RogerDeng/sdlocker-tiny/hardware_smol/sd_slot.STEP

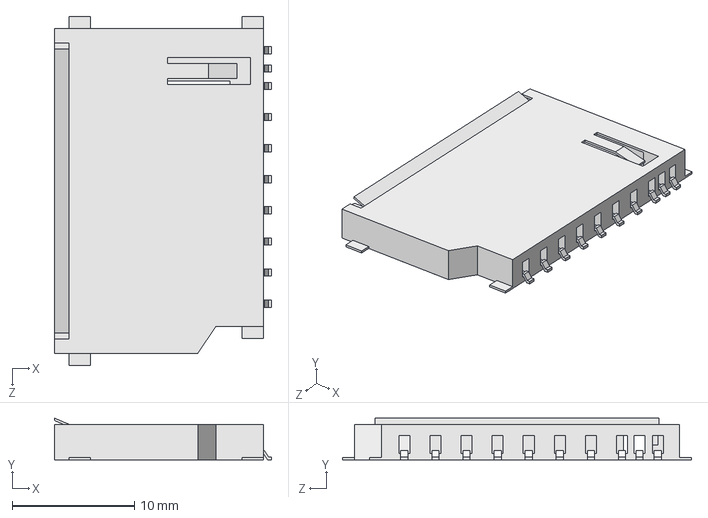
[picture p1: CAD file, 2022-03-17]
hardware_smol/sd_slot.STEP
17.8 x 3.40 x 28.5 mm
