RogerDeng/sdlocker-tiny/hardware_smol/sd_locker.kicad_pcb

## KiCad design hardware_smol/sd_locker.kicad_pcb (2022-03-17)

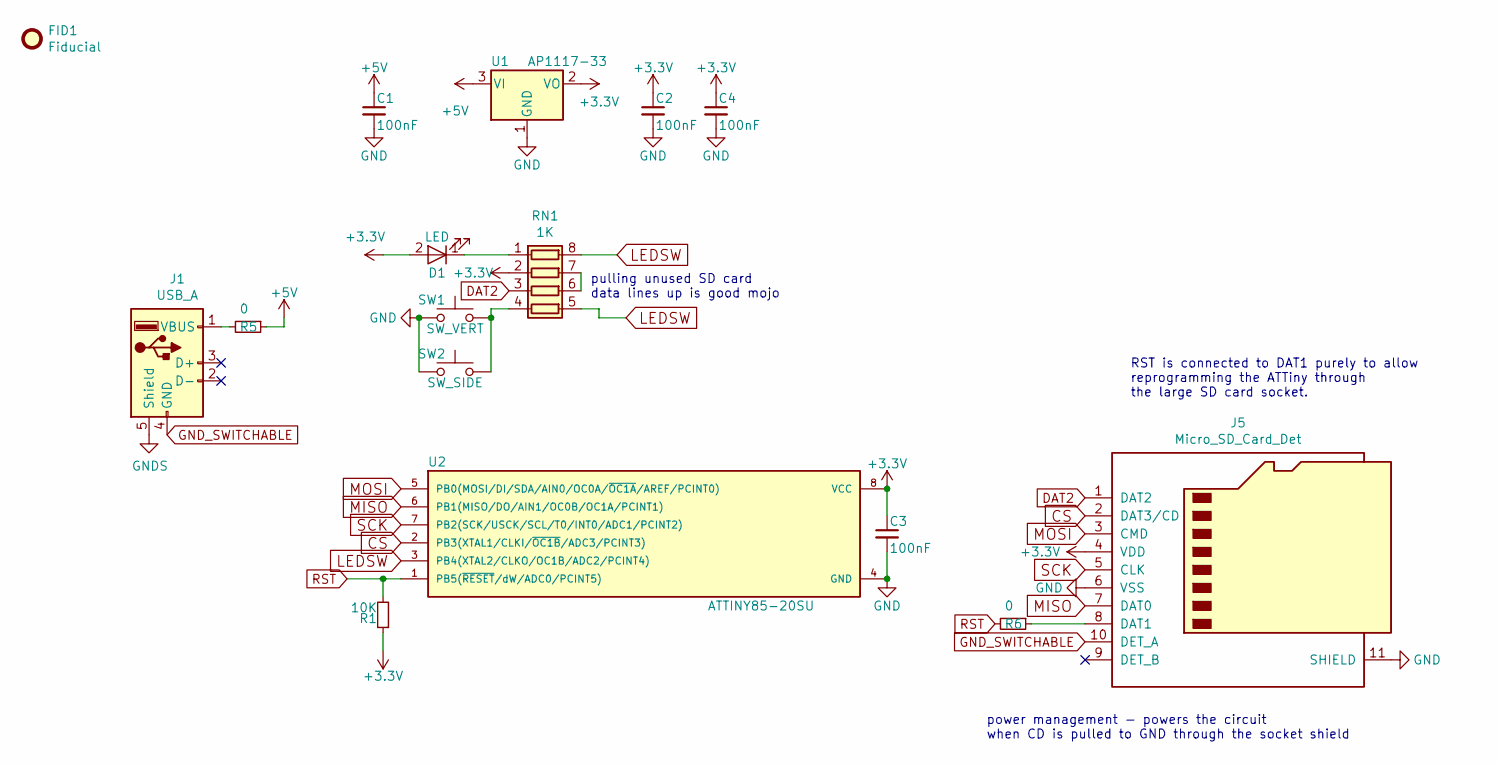
[picture p2: schematic sd_locker.sch]

Parts:
C1, C2, C3, C4: 100nF; C_0805_100nF_HandSoldering
D1: LED; LED_0805_HandSoldering
FID1: Fiducial; Fiducial_1.5mm_Mask3mm
J1: USB_A; USB_A_CNCTech_1001-011-01101_Horizontal
J5: Micro_SD_Card_Det; microSD-Receptacle-SelfEject
R1: 10K; R_0805_10K_HandSoldering
R5, R6: 0; R_0603_1608Metric_Pad1.05x0.95mm_HandSolder
RN1: 1K; R_Array_Concave_4x0402
SW1: SW_VERT; SW_SPST_EVQPE1
SW2: SW_SIDE; Panasonic_EVQPUL_EVQPUC
U1: AP1117-33; SOT-223-3_TabPin2
U2: ATTINY85-20SU; SOIJ-8_5.3x5.3mm_Pitch1.27mm

Connections:
+3V3: C2.1, C3.1, C4.1, D1.2 (A), J5.4 (VDD), R1.1, RN1.2 (R2.1), U1.2 (VO), U2.8 (VCC)
+5V: C1.1, R5.1, U1.3 (VI)
CS: J5.2 (DAT3/CD), U2.2 (PB3(XTAL1/CLKI/~OC1B~/ADC3/PCINT3))
DAT2: J5.1 (DAT2), RN1.3 (R3.1)
GND: C1.2, C2.2, C3.2, C4.2, J5.6 (VSS), J5.11 (SHIELD), SW1.2, SW2.2, U1.1 (GND), U2.4 (GND)
GNDS: J1.5 (Shield)
GND_SWITCHABLE: J1.4 (GND), J5.10 (DET_A)
LEDSW: RN1.5 (R4.2), RN1.8 (R1.2), U2.3 (PB4(XTAL2/CLKO/OC1B/ADC2/PCINT4))
MISO: J5.7 (DAT0), U2.6 (PB1(MISO/DO/AIN1/OC0B/OC1A/PCINT1))
MOSI: J5.3 (CMD), U2.5 (PB0(MOSI/DI/SDA/AIN0/OC0A/~OC1A~/AREF/P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)
unnamed: D1.1 (K), RN1.1 (R1.1)
unnamed: J1.1 (VBUS), R5.2
unnamed: J5.8 (DAT1), R6.1
unnamed: RN1.4 (R4.1), SW1.1, SW2.1
unnamed: RN1.6 (R3.2), RN1.7 (R2.2)
RST: R1.2, R6.2, U2.1 (PB5(~RESET~/dW/ADC0/PCINT5))
SCK: J5.5 (CLK), U2.7 (PB2(SCK/USCK/SCL/T0/INT0/ADC1/PCINT2))

Notes on the sheet:
RST is connected to DAT1 purely to allow reprogramming the ATTiny through the large SD card socket.
power management - powers the circuit when CD is pulled to GND through the socket shield
pulling unused SD card data lines up is good mojo

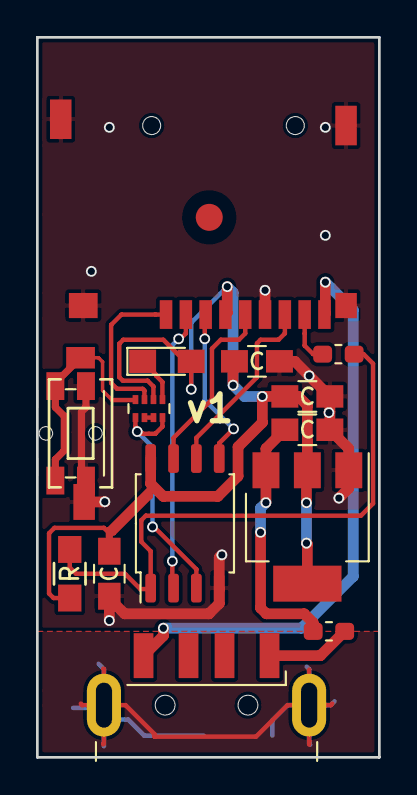
[picture p3: board sd_locker.kicad_pcb from above]

Board: 2 copper layers, 19.0 x 40.0 mm, 16 parts (0 on the bottom side), 16 nets.
