RogerDeng/sdlocker-tiny/hardware_smol/programming_adapter/usd-adapter.kicad_pcb

## KiCad design hardware_smol/programming_adapter/usd-adapter.kicad_pcb (2022-03-17)

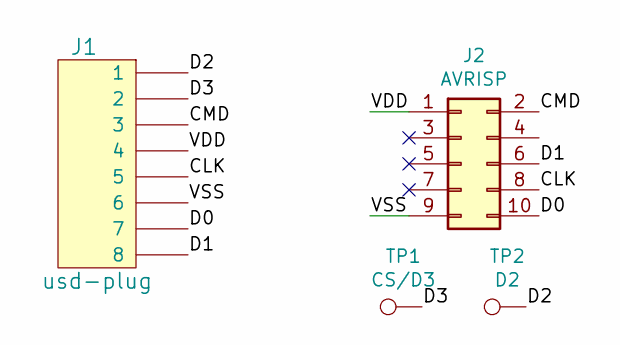
[picture p4: schematic usd-adapter.sch, Micro SD card adapter]

Parts:
J1: usd-plug; usd
J2: AVRISP; Side_2x5_Connector_SMD
TP1: CS/D3; TestPoint_Pad_1.0x1.0mm
TP2: D2; TestPoint_Pad_1.0x1.0mm

Connections:
/CLK: J1.5, J2.8
/CMD: J1.3, J2.2
/D0: J1.7, J2.10
/D1: J1.8, J2.6
/D2: J1.1, TP2.1
/D3: J1.2, TP1.1
/VDD: J1.4, J2.1
/VSS: J1.6, J2.9

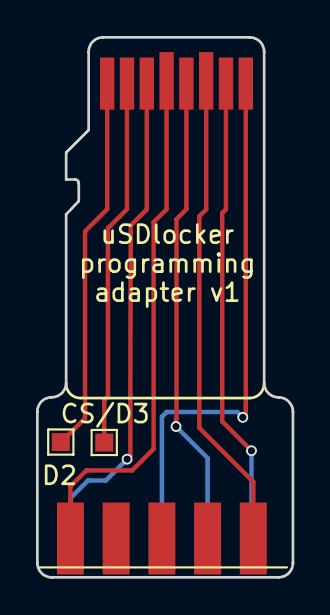
[picture p5: board usd-adapter.kicad_pcb from above]

Board: 2 copper layers, 14.2 x 30.0 mm, 4 parts (0 on the bottom side), 8 nets.
