RogerDeng/sdlocker-tiny/(commit log)

2018-12-15 I have broken pinout on rev1 of my PCBs, working around some of it in software
    [sdlocker-tiny.cpp]
2018-12-15 Added PERM bit support and dynamic TMP-to-PERM switching when the button is pressed on boot
2018-12-16 Adding hardware - v1, broken
    [sd_locker.kicad_pcb, sd_locker.sch]
2019-11-03 Fixing the SD slot footprint to match the pinout of the KiCad SD card holder symbol, adding the card detect pin
2019-11-03 Adding the 3D model for the SD slot
    [sd_slot.STEP]
2019-11-03 Unverified - fixing the SD locker PCB layout so that airwires are not needed for SD slot connection, adding proper CD wire, adding 0R resistor for easier "battery-powered SD locker" modding
    [sd_locker.kicad_pcb, sd_locker.sch]
2019-11-19 Latest hardware version (v2) added
    [sd_locker.kicad_pcb, sd_locker.sch]
2019-11-19 Adding a fiducial on the bottom layer
    [sd_locker.kicad_pcb, sd_locker.sch]
2021-09-25 Latest hardware revision, v3, wasn't uplaoded for a long time - fixed
    [sd_locker.kicad_pcb, sd_locker.sch]
2021-09-25 removing the BROKEN_PINOUT code since it was 1) glitchy 2) unnecessary
    [sdlocker-tiny.cpp]
2021-09-25 Adding a statically-generated CRC table which allows this code to work on a Tiny45, with RAM to spare. Commenting out runtime CRC table generation code, just in case - that's how git works, right?
2021-09-25 Switching default makefile to usbasp-clone since that's what people will most likely use with my hardware
2021-09-25 Adding fuse settings to the default makefile
2021-09-25 adding -O2 to make - uhh, just in case?
2022-03-17 Adding uSDlocker hardware files
    [sd_locker.kicad_pcb, sd_locker.sch, sd_slot.STEP, usd-adapter.kicad_pcb, usd-adapter.sch]
