RogerDeng/sdlocker-tiny/(notices)

Notices in the files:
hardware_smol/programming_adapter/usd-adapter.kicad_pcb:
Copyright (c) 2016 Samsung Electronics Co., Ltd All Rights Reserved
